MagnusNM/TANG/Hardware/Tang_v2/Datasheets/24V-12V buck/uc3843b setup.png

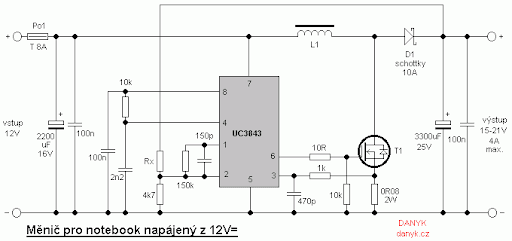
Hardware/Tang_v2/Datasheets/24V-12V buck/uc3843b setup.png
