MagnusNM/TANG/Hardware/Tang_v1-1/tang_v1-1.pdf

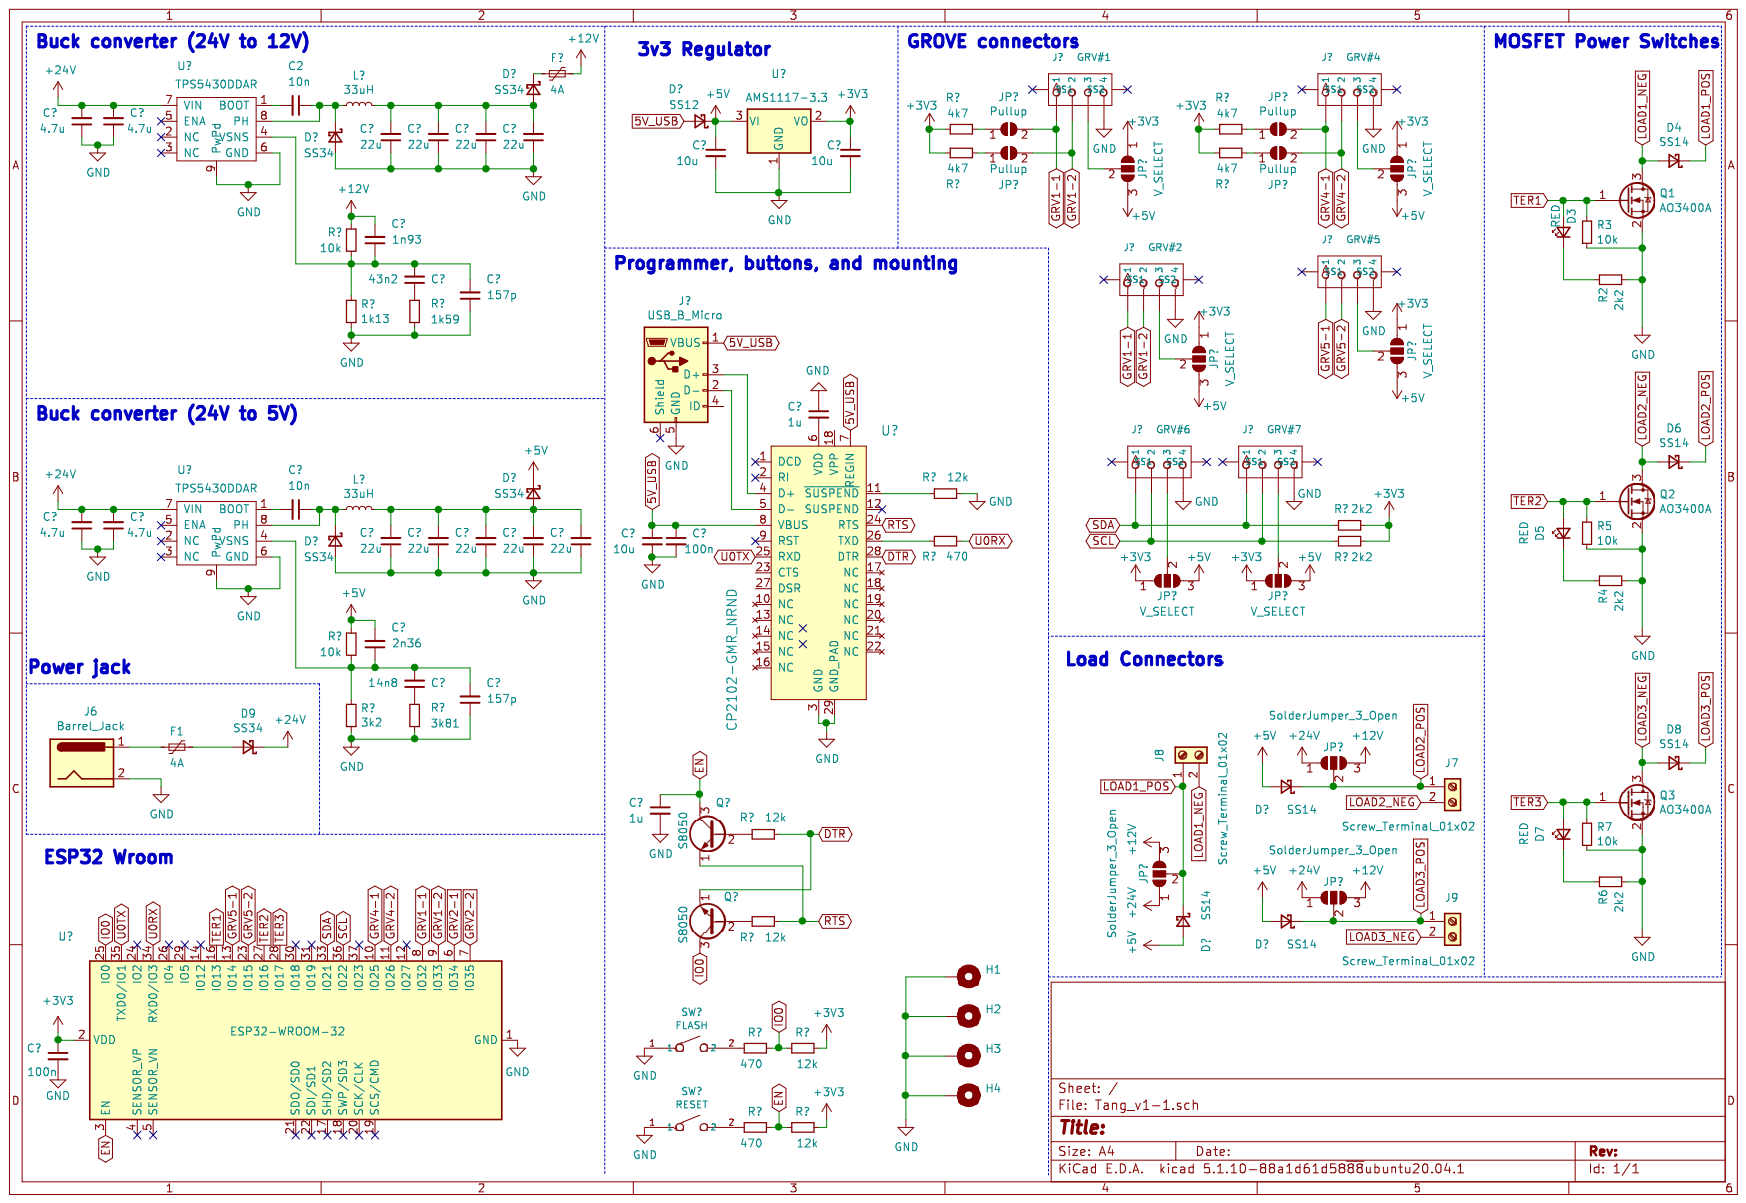
[picture p2: page 1]
