MagnusNM/TANG/Hardware/Tang_v1-0/Control_board.kicad_pcb

## KiCad design Hardware/Tang_v1-0/Control_board.kicad_pcb (2021-07-06)

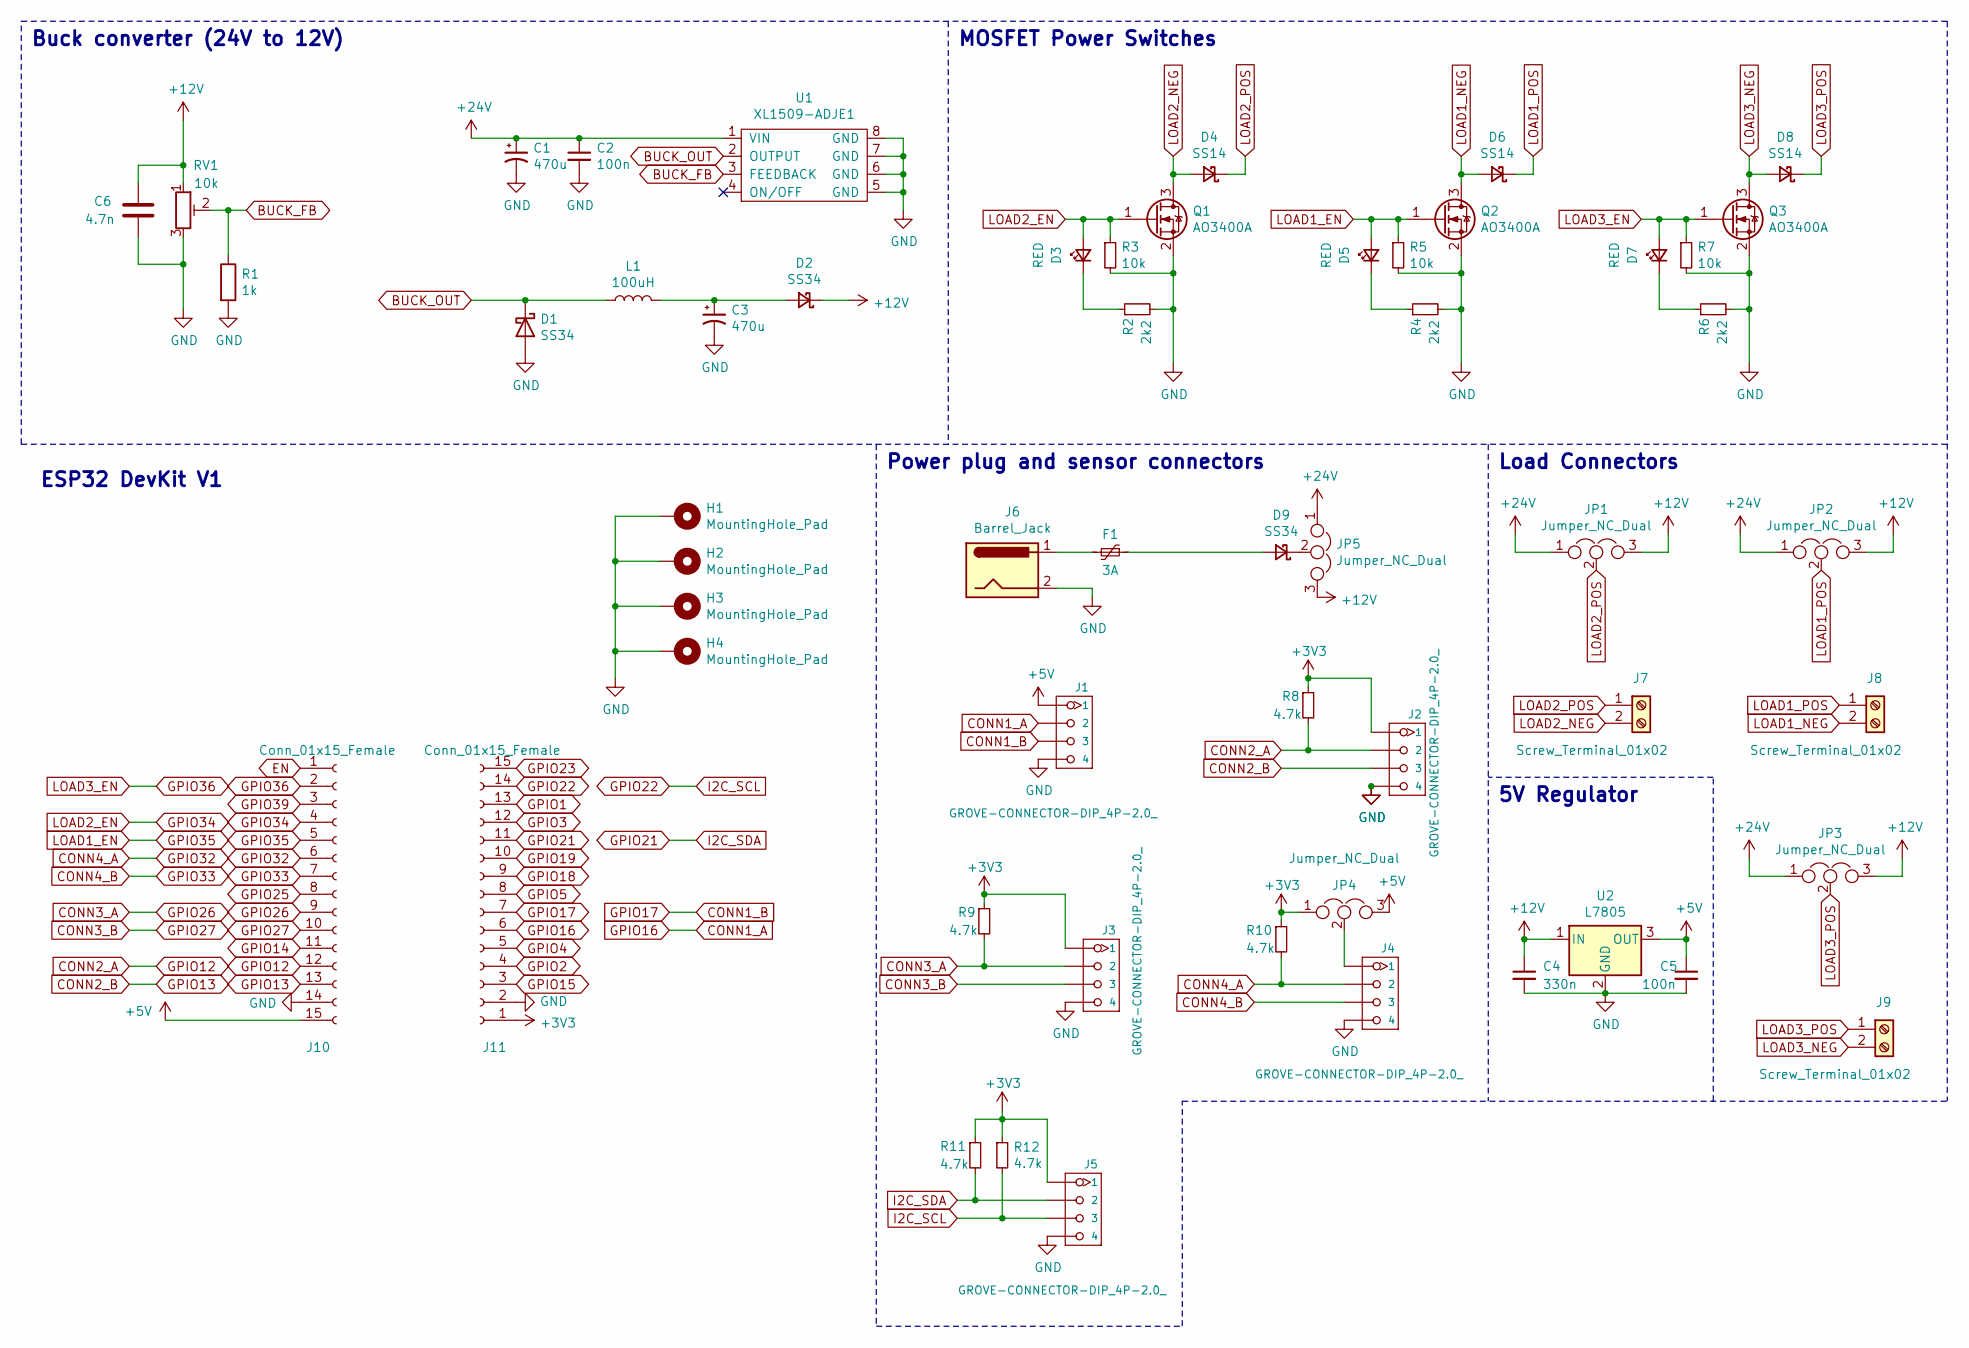
[picture p3: schematic Control_board.sch]

Parts:
C1, C3: 470u; C_Elec_10x10.2; LCSC Part # C3350
C2: 100n; C_0603_1608Metric; LCSC Part # C14663
C4: 330n; C_0805_2012Metric; LCSC Part # C1740
C5: 100n; C_0805_2012Metric; LCSC Part # C49678
C6: 4.7n; C_0402_1005Metric; LCSC Part # C1538
D1, D2, D9: SS34; D_SMA; LCSC Part # C8678
D3, D5, D7: RED; LED_0603_1608Metric; LCSC Part # C2286
D4, D6, D8: SS14; D_SMA; LCSC Part # C2480
F1: 3A; Fuse_1812_4532Metric; LCSC Part # C32404
H1, H2, H3, H4: MountingHole_Pad; MountingHole_3.2mm_M3_Pad_Via
J1, J2, J3, J4, J5: GROVE-CONNECTOR-DIP_4P-2.0_; NS-Tech_Grove_1x04_P2mm_Vertical
J6: Barrel_Jack; BarrelJack_Horizontal
J7, J8, J9: Screw_Terminal_01x02; TerminalBlock_Phoenix_MPT-0,5-2-2.54_1x02_P2.54mm_Horizontal
J10, J11: Conn_01x15_Female; PinSocket_1x15_P2.54mm_Vertical
JP1, JP2, JP3, JP4, JP5: Jumper_NC_Dual; PinHeader_1x03_P2.54mm_Vertical
L1: 100uH; Wuerth_7447211101; LCSC Part # C429814
Q1, Q2, Q3: AO3400A; SOT-23; LCSC Part # C344010
R1: 1k; R_0603_1608Metric; LCSC Part # C21190
R2, R4, R6: 2k2; R_0603_1608Metric; LCSC Part # C4190
R3, R5, R7: 10k; R_0603_1608Metric; LCSC Part # C25804
R8, R9, R10, R11, R12: 4.7k; R_0402_1005Metric; LCSC Part # C25900
RV1: 10k; Potentiometer_Bourns_3296P_Horizontal
U1: XL1509-ADJE1; SOP-8_3.9x4.9mm_P1.27mm; LCSC Part # C74192
U2: L7805; TO-263-2; LCSC Part # C15077

Connections:
+3V3: J2.1, J3.1, J5.1, J11.1, JP4.1, R8.1, R9.1, R10.1, R11.1, R12.1
+5V: C5.1, J1.1, J10.15, JP4.3, U2.3 (OUT)
+12V: C4.1, C6.1, D2.1 (K), JP1.3, JP2.3, JP3.3, JP5.3, RV1.1, U2.1 (IN)
+24V: C1.1, C2.1, JP1.1, JP2.1, JP3.1, JP5.1, U1.1 (VIN)
BUCK_FB: R1.1, RV1.2, U1.3 (FEEDBACK)
BUCK_OUT: D1.1 (K), L1.1, L1.3, U1.2 (OUTPUT)
CONN1_A: J1.2, J11.6
CONN1_B: J1.3, J11.7
CONN2_A: J2.2, J10.12, R8.2
CONN2_B: J2.3, J10.13
CONN3_A: J3.2, J10.9, R9.2
CONN3_B: J3.3, J10.10
CONN4_A: J4.2, J10.6, R10.2
CONN4_B: J4.3, J10.7
EN: J10.1
GND: C1.2, C2.2, C3.2, C4.2, C5.2, C6.2, D1.2 (A), H1.1, H2.1, H3.1, H4.1, J1.4, J2.4, J3.4, J4.4, J5.4, J6.2, J10.14, J11.2, Q1.2 (S), Q2.2 (S), Q3.2 (S), R1.2, R2.2, R3.2, R4.2, R5.2, R6.2, R7.2, RV1.3, U1.5 (GND), U1.6 (GND), U1.7 (GND), U1.8 (GND), U2.2 (GND)
GPIO1: J11.13
GPIO2: J11.4
GPIO3: J11.12
GPIO4: J11.5
GPIO5: J11.8
GPIO14: J10.11
GPIO15: J11.3
GPIO18: J11.9
GPIO19: J11.10
GPIO21: J5.2, J11.11, R11.2
GPIO22: J5.3, J11.14, R12.2
GPIO23: J11.15
GPIO25: J10.8
GPIO34: D3.2 (A), J10.4, Q1.1 (G), R3.1
GPIO35: D5.2 (A), J10.5, Q2.1 (G), R5.1
GPIO36: D7.2 (A), J10.2, Q3.1 (G), R7.1
GPIO39: J10.3
LOAD1_NEG: D6.2 (A), J8.2, Q2.3 (D)
LOAD1_POS: D6.1 (K), J8.1, JP2.2
LOAD2_NEG: D4.2 (A), J7.2, Q1.3 (D)
LOAD2_POS: D4.1 (K), J7.1, JP1.2
LOAD3_NEG: D8.2 (A), J9.2, Q3.3 (D)
LOAD3_POS: D8.1 (K), J9.1, JP3.2
unnamed: C3.1, D2.2 (A), L1.2
unnamed: D3.1 (K), R2.1
unnamed: D5.1 (K), R4.1
unnamed: D7.1 (K), R6.1
unnamed: D9.1 (K), JP5.2
unnamed: D9.2 (A), F1.1
unnamed: F1.2, J6.1
unnamed: J4.1, JP4.2

Notes on the sheet:
Buck converter (24V to 12V)
MOSFET Power Switches
Load Connectors
5V Regulator
Power plug and sensor connectors
ESP32 DevKit V1

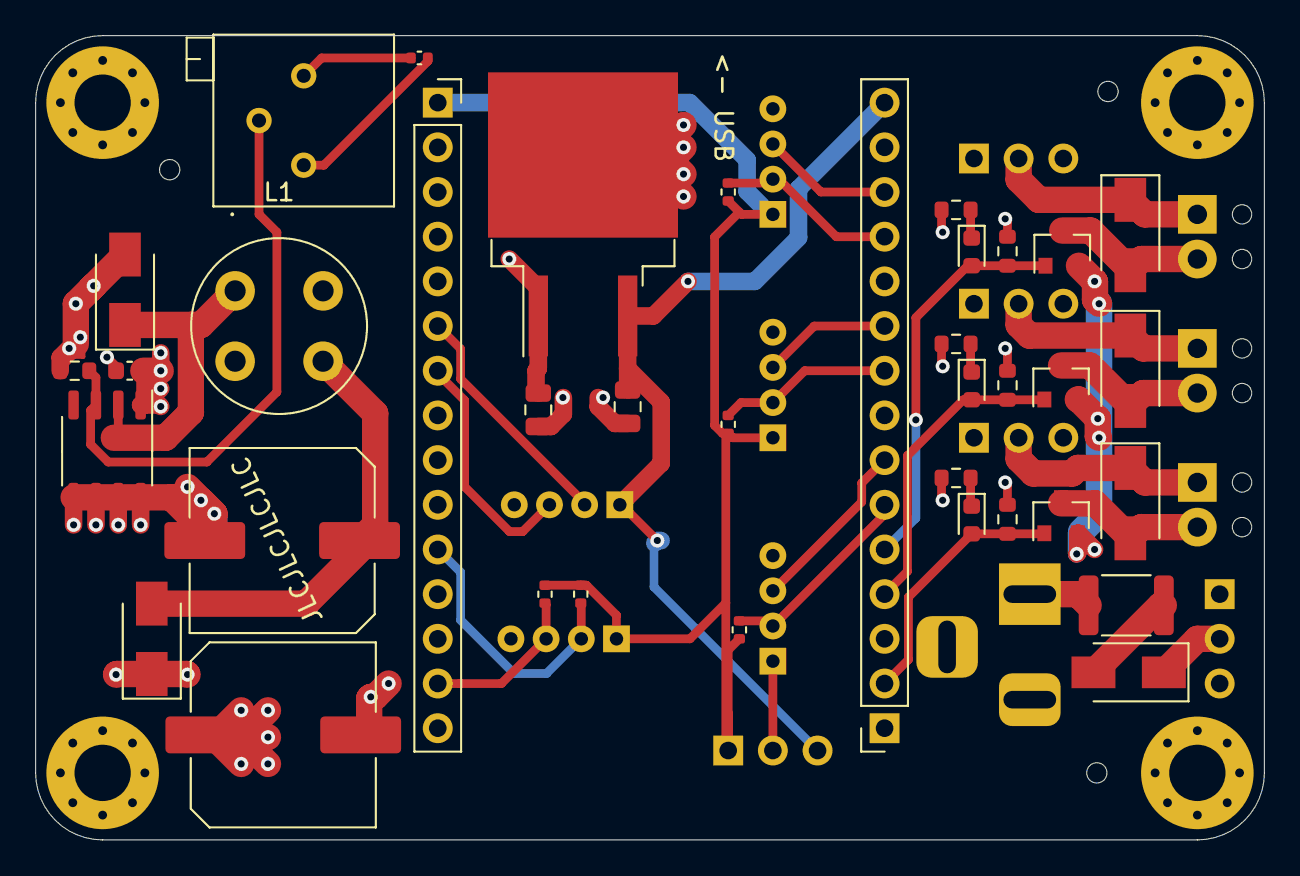
[picture p4: board Control_board.kicad_pcb from above]

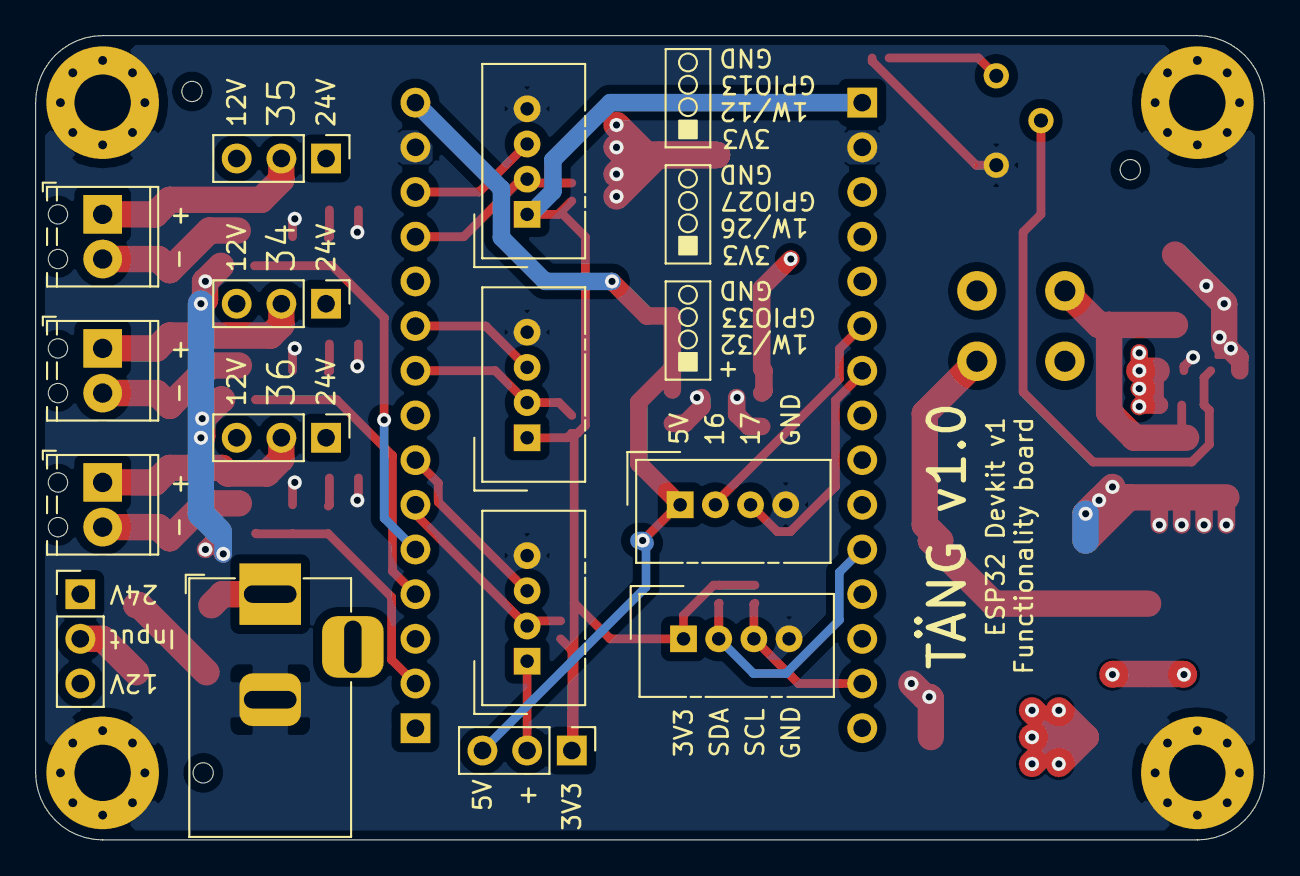
[picture p5: board Control_board.kicad_pcb from below]

Board: 4 copper layers, 69.8 x 45.7 mm, 55 parts (14 on the bottom side), 34 nets.
