MagnusNM/TANG/Hardware/Tang_v1-1/Tang_v1-1.kicad_pcb

## KiCad design Hardware/Tang_v1-1/Tang_v1-1.kicad_pcb (2021-07-13)

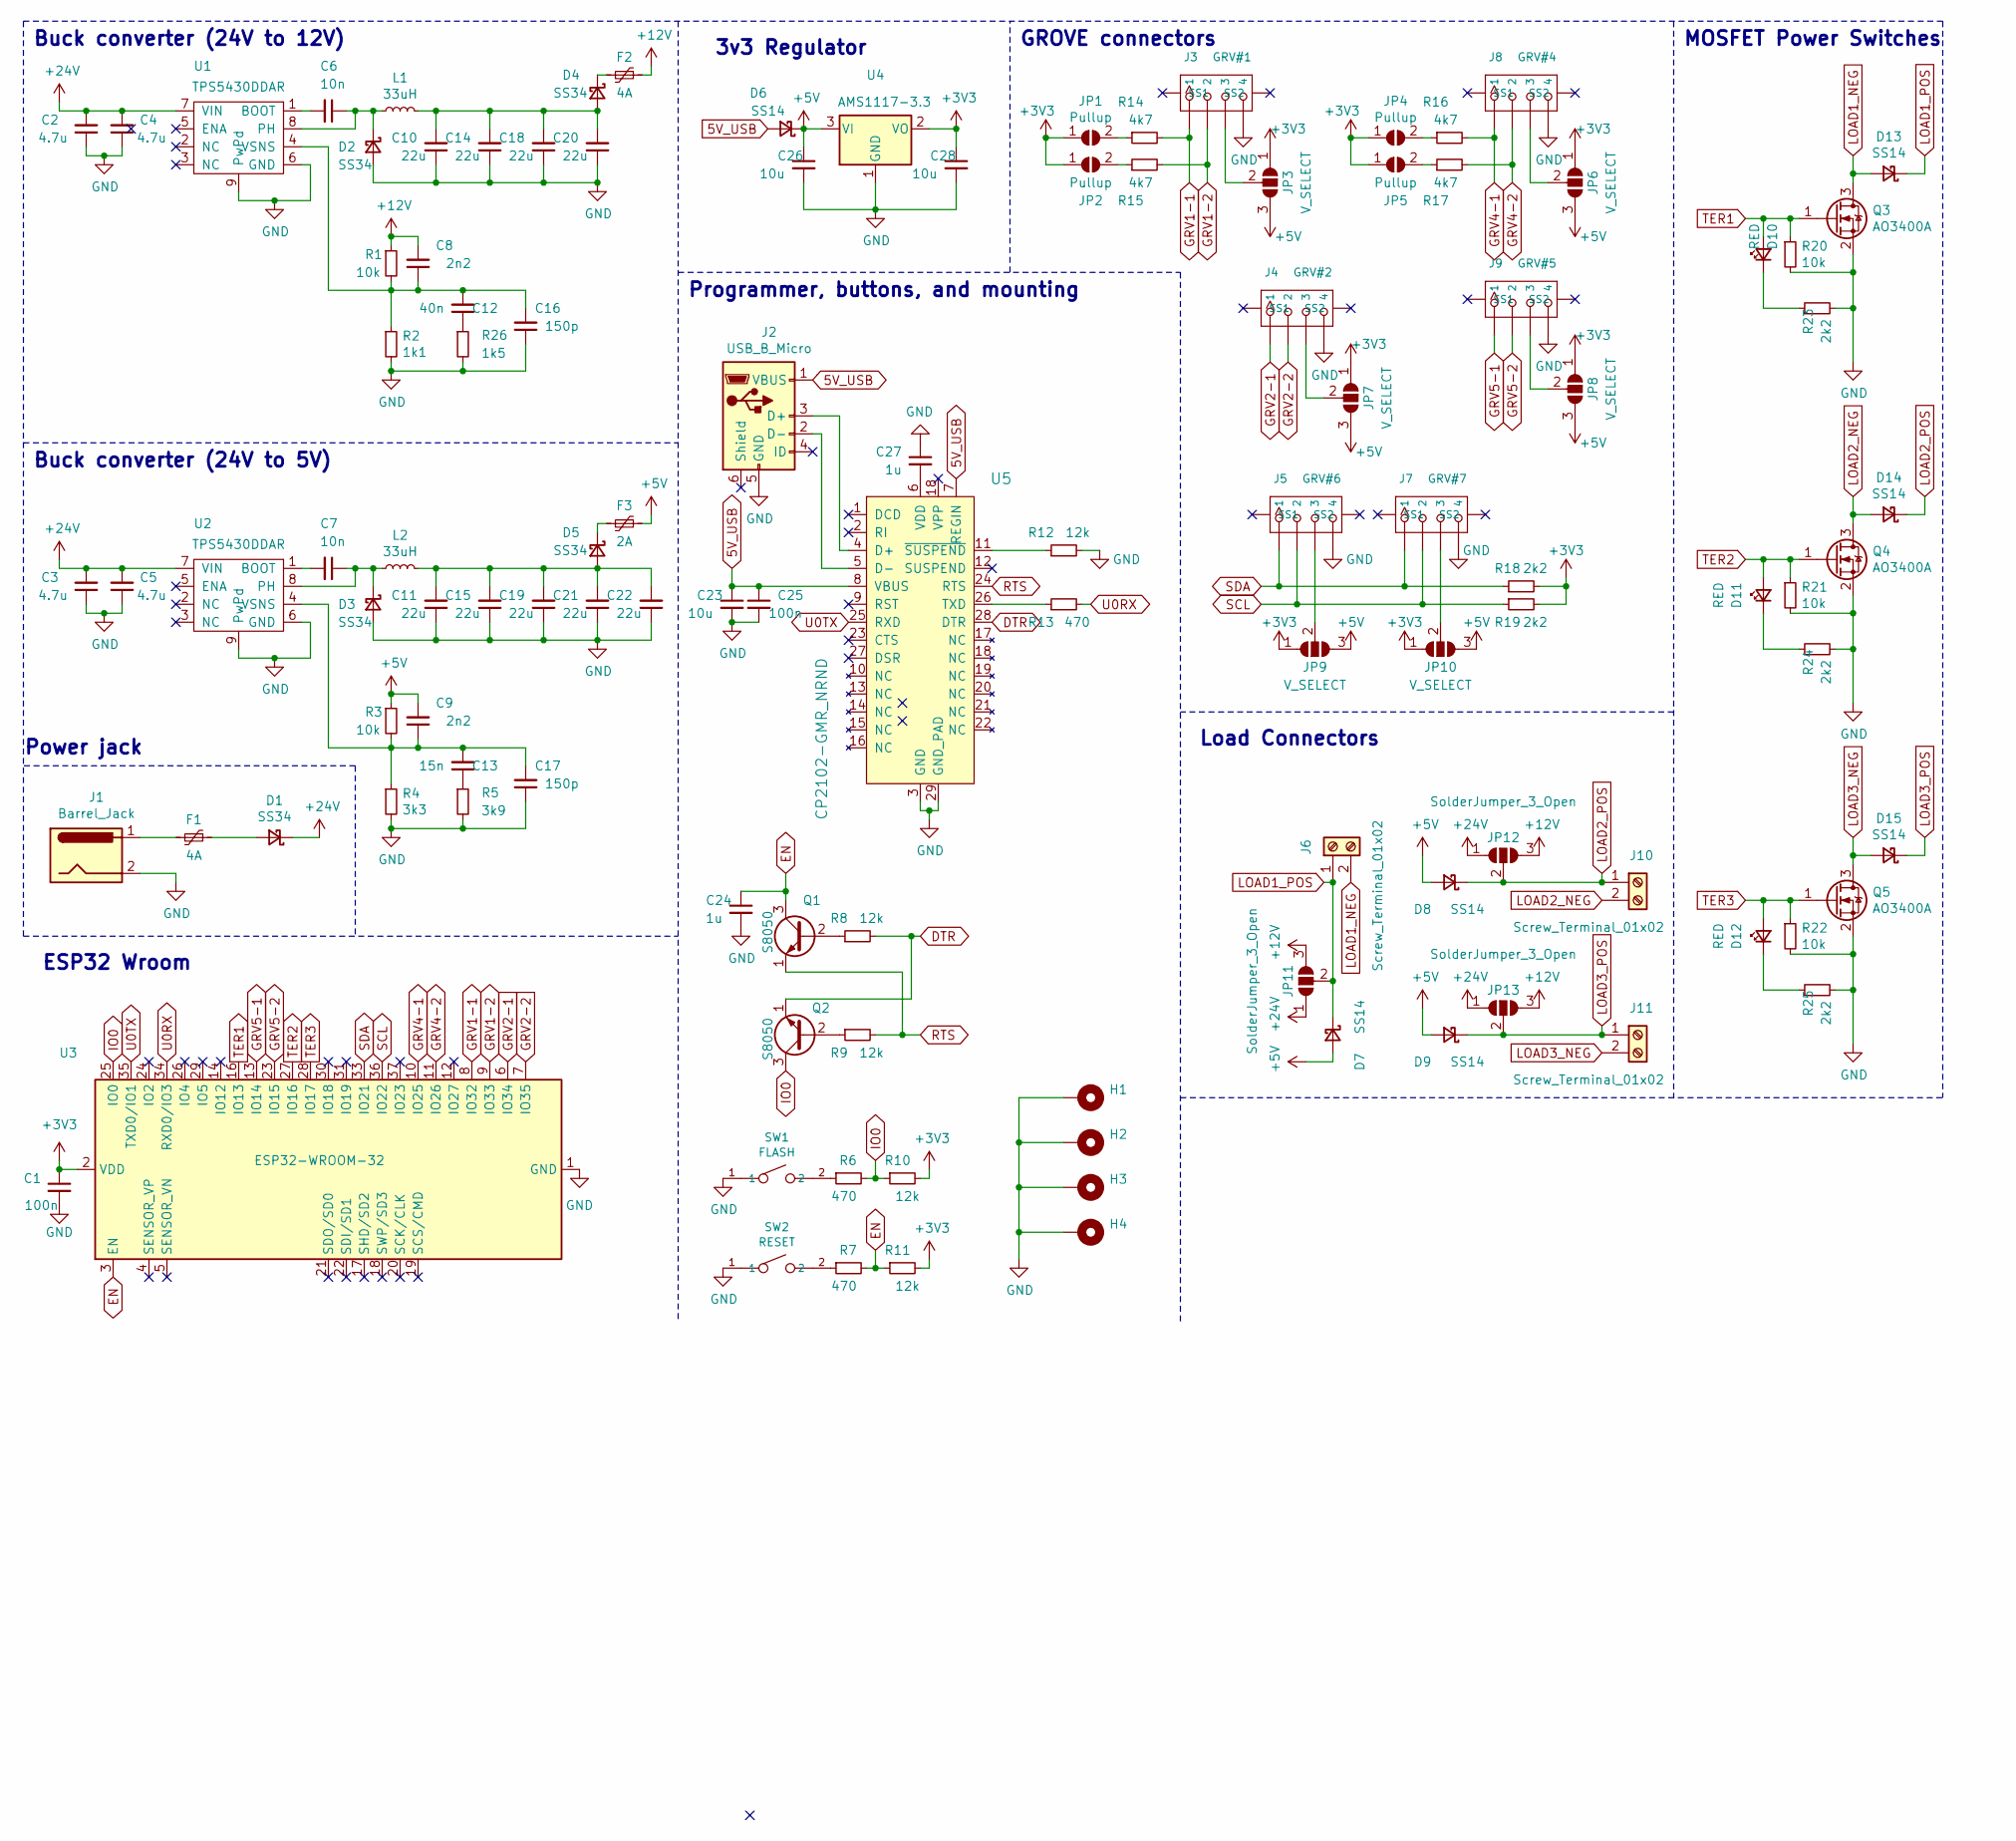
[picture p6: schematic Tang_v1-1.sch]

Parts:
C1, C25: 100n; C_0603_1608Metric; LCSC C14663
C2, C3, C4, C5: 4.7u; C_1206_3216Metric; LCSC Part # C29823
C6, C7: 10n; C_0603_1608Metric; LCSC Part # C57112
C8, C9: 2n2; C_0603_1608Metric; LCSC Part # C1604
C10, C11, C14, C15, C18, C19, C20, C21, C22: 22u; C_0805_2012Metric; LCSC Part # C45783
C12: 40n; C_0805_2012Metric; LCSC Part # C502151
C13: 15n; C_0603_1608Metric; LCSC Part # C1596
C16, C17: 150p; C_0603_1608Metric; LCSC Part # C1594
C23: 10u; C_0805_2012Metric; LCSC C15850
C24, C27: 1u; C_0603_1608Metric; LCSC C15849
C26, C28: 10u; C_0805_2012Metric; LCSC Part # C15850
D1: SS34; D_SMA; LCSC Part # C8678
D2, D3, D4, D5: SS34; D_SMA; LCSC C8678
D6, D7, D8, D9: SS14; D_SMA; LCSC C2480
D10, D11, D12: RED; LED_0603_1608Metric; LCSC Part # C2286
D13, D14, D15: SS14; D_SMA; LCSC Part # C2480
F1, F2: 4A; Fuse_1812_4532Metric; LCSC Part # C960026
F3: 2A; Fuse_1812_4532Metric; LCSC Part # C269134
H1, H2, H3, H4: MountingHole_Pad; MountingHole_3.2mm_M3_Pad_Via
J1: Barrel_Jack; BarrelJack_Horizontal
J2: USB_B_Micro; USB_Micro-B_Molex-105017-0001; LCSC C10418
J3: GRV#1; GROVE 4 pin 90deg SMD
J4: GRV#2; GROVE 4 pin 90deg SMD
J5: GRV#6; GROVE 4 pin 90deg SMD
J6, J10, J11: Screw_Terminal_01x02; TerminalBlock_Phoenix_MKDS-1,5-2-5.08_1x02_P5.08mm_Horizont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
J7: GRV#7; GROVE 4 pin 90deg SMD
J8: GRV#4; GROVE 4 pin 90deg SMD
J9: GRV#5; GROVE 4 pin 90deg SMD
JP1, JP2, JP4, JP5: Pullup; SolderJumper-2_P1.3mm_Open_RoundedPad1.0x1.5mm
JP3, JP6, JP7, JP8, JP9, JP10: V_SELECT; SolderJumper-3_P1.3mm_Open_RoundedPad1.0x1.5mm
JP11, JP12, JP13: SolderJumper_3_Open; SolderJumper-3_P1.3mm_Open_RoundedPad1.0x1.5mm
L1, L2: 33uH; L_TDG_11.5x10x4mm
Q1, Q2: S8050; SOT-23; LCSC C2146
Q3, Q4, Q5: AO3400A; SOT-23; LCSC Part # C20917
R1, R3: 10k; R_0603_1608Metric; LCSC C25804
R2: 1k1; R_0603_1608Metric; LCSC C22764
R4: 3k3; R_0603_1608Metric; LCSC C22978
R5: 3k9; R_0603_1608Metric; LCSC C23018
R6, R7, R13: 470; R_0603_1608Metric; LCSC Part # C23179
R8, R9, R10, R11, R12: 12k; R_0603_1608Metric; LCSC Part # C22790
R14, R15, R16, R17: 4k7; R_0603_1608Metric; LCSC Part # C23162
R18, R19, R23, R24, R25: 2k2; R_0603_1608Metric; LCSC Part # C4190
R20, R21, R22: 10k; R_0603_1608Metric; LCSC Part # C25804
R26: 1k5; R_0603_1608Metric; LCSC C22843
SW1: FLASH; SW_Push_SPST_NO_Alps_SKRK; MPN B3U-1000P-2P-SMD; LCSC C115357
SW2: RESET; SW_Push_SPST_NO_Alps_SKRK; MPN B3U-1000P-2P-SMD; LCSC C115357
U1, U2: TPS5430DDAR; HSOP-8-1EP_3.9x4.9mm_P1.27mm_EP2.41x3.1mm; LCSC C9864
U3: ESP32-WROOM-32; LCSC C82899
U4: AMS1117-3.3; SOT-223-3_TabPin2; LCSC C6186
U5: CP2102-GMR_NRND; VFQFN-28-1EP_5x5mm; MPN CP2102-GMR; Digi-Key_PN 336-1160-1-ND

Connections:
5V_USB: C23.1, C25.1, D6.2 (A), J2.1 (VBUS), U5.7 (REGIN), U5.8 (VBUS)
+3V3: C1.1, C28.1, JP1.1 (A), JP2.1 (A), JP3.1 (A), JP4.1 (A), JP5.1 (A), JP6.1 (A), JP7.1 (A), JP8.1 (A), JP9.1 (A), JP10.1 (A), R10.2, R11.2, R18.2, R19.2, U3.2 (VDD), U4.2 (VO)
+5V: C9.2, C26.1, D6.1 (K), D7.2 (A), D8.2 (A), D9.2 (A), F3.1, JP3.3 (B), JP6.3 (B), JP7.3 (B), JP8.3 (B), JP9.3 (B), JP10.3 (B), R3.1, U4.3 (VI)
+12V: C8.2, F2.1, JP11.3 (B), JP12.3 (B), JP13.3 (B), R1.1
+24V: C2.2, C3.2, C4.2, C5.2, D1.1 (K), JP11.1 (A), JP12.1 (A), JP13.1 (A), U1.7 (VIN), U2.7 (VIN)
DTR: Q2.1 (E), R8.2, U5.28 (DTR)
EN: C24.1, Q1.3 (C), R7.2, R11.1, U3.3 (EN)
GND: C1.2, C2.1, C3.1, C4.1, C5.1, C10.1, C11.1, C14.1, C15.1, C16.1, C17.1, C18.1, C19.1, C20.1, C21.1, C22.1, C23.2, C24.2, C25.2, C26.2, C27.1, C28.2, D2.2 (A), D3.2 (A), H1.1, H2.1, H3.1, H4.1, J1.2, J2.5 (GND), J3.4, J4.4, J5.4, J7.4, J8.4, J9.4, Q3.2 (S), Q4.2 (S), Q5.2 (S), R2.2, R4.2, R5.2, R12.2, R20.2, R21.2, R22.2, R23.2, R24.2, R25.2, R26.2, SW1.1, SW2.1, U1.6 (GND), U1.9 (PwPd), U2.6 (GND), U2.9 (PwPd), U3.1 (GND), U3.15 (GND), U3.38 (GND), U3.39 (GND), U4.1 (GND), U5.3 (GND), U5.29 (GND_PAD)
GRV1-1: J3.1, R14.2, U3.8 (IO32)
GRV1-2: J3.2, R15.2, U3.9 (IO33)
GRV2-1: J4.1, U3.6 (IO34)
GRV2-2: J4.2, U3.7 (IO35)
GRV4-1: J8.1, R16.2, U3.10 (IO25)
GRV4-2: J8.2, R17.2, U3.11 (IO26)
GRV5-1: J9.1, U3.13 (IO14)
GRV5-2: J9.2, U3.23 (IO15)
IO0: Q2.3 (C), R6.2, R10.1, U3.25 (IO0)
LOAD1_NEG: D13.2 (A), J6.2, Q3.3 (D)
LOAD1_POS: D7.1 (K), D13.1 (K), J6.1, JP11.2 (C)
LOAD2_NEG: D14.2 (A), J10.2, Q4.3 (D)
LOAD2_POS: D8.1 (K), D14.1 (K), J10.1, JP12.2 (C)
LOAD3_NEG: D15.2 (A), J11.2, Q5.3 (D)
LOAD3_POS: D9.1 (K), D15.1 (K), J11.1, JP13.2 (C)
unnamed: C6.1, D2.1 (K), L1.1, U1.8 (PH)
unnamed: C6.2, U1.1 (BOOT)
unnamed: C7.1, D3.1 (K), L2.1, U2.8 (PH)
unnamed: C7.2, U2.1 (BOOT)
unnamed: C10.2, C14.2, C18.2, C20.2, D4.2 (A), L1.2
unnamed: C11.2, C15.2, C19.2, C21.2, C22.2, D5.2 (A), L2.2
unnamed: C12.1, R26.1
unnamed: C8.1, C12.2, C16.2, R1.2, R2.1, U1.4 (VSNS)
unnamed: C13.1, R5.1
unnamed: C9.1, C13.2, C17.2, R3.2, R4.1, U2.4 (VSNS)
unnamed: C27.2, U5.6 (VDD)
unnamed: D1.2 (A), F1.1
unnamed: D4.1 (K), F2.2
unnamed: D5.1 (K), F3.2
unnamed: D10.1 (K), R23.1
unnamed: D11.1 (K), R24.1
unnamed: D12.1 (K), R25.1
unnamed: F1.2, J1.1
unnamed: J2.2 (D-), U5.5 (D-)
unnamed: J2.3 (D+), U5.4 (D+)
unnamed: J3.3, JP3.2 (C)
unnamed: J4.3, JP7.2 (C)
unnamed: J5.3, JP9.2 (C)
unnamed: J7.3, JP10.2 (C)
unnamed: J8.3, JP6.2 (C)
unnamed: J9.3, JP8.2 (C)
unnamed: JP1.2 (B), R14.1
unnamed: JP2.2 (B), R15.1
unnamed: JP4.2 (B), R16.1
unnamed: JP5.2 (B), R17.1
unnamed: Q1.2 (B), R8.1
unnamed: Q2.2 (B), R9.1
unnamed: R6.1, SW1.2
unnamed: R7.1, SW2.2
unnamed: R12.1, U5.11 (~SUSPEND)
unnamed: R13.1, U5.26 (TXD)
RTS: Q1.1 (E), R9.2, U5.24 (RTS)
SCL: J5.2, J7.2, R19.1, U3.36 (IO22)
SDA: J5.1, J7.1, R18.1, U3.33 (IO21)
TER1: D10.2 (A), Q3.1 (G), R20.1, U3.16 (IO13)
TER2: D11.2 (A), Q4.1 (G), R21.1, U3.27 (IO16)
TER3: D12.2 (A), Q5.1 (G), R22.1, U3.28 (IO17)
U0RX: R13.2, U3.34 (RXD0/IO3)
U0TX: U3.35 (TXD0/IO1), U5.25 (RXD)

Notes on the sheet:
Buck converter (24V to 12V)
MOSFET Power Switches
Load Connectors
Programmer, buttons, and mounting
ESP32 Wroom
3v3 Regulator
Buck converter (24V to 5V)
GROVE connectors
Power jack

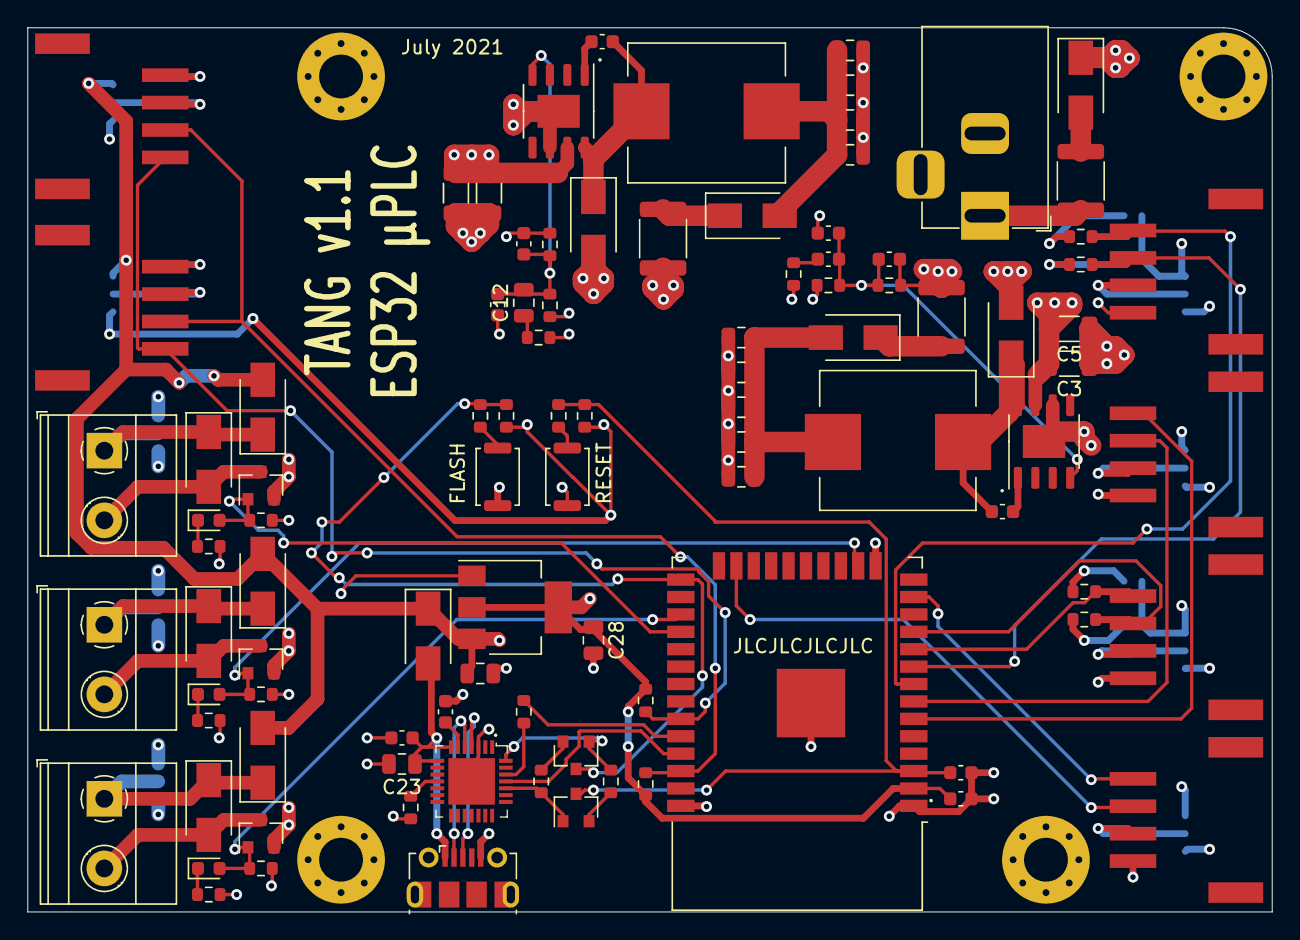
[picture p7: board Tang_v1-1.kicad_pcb from above]

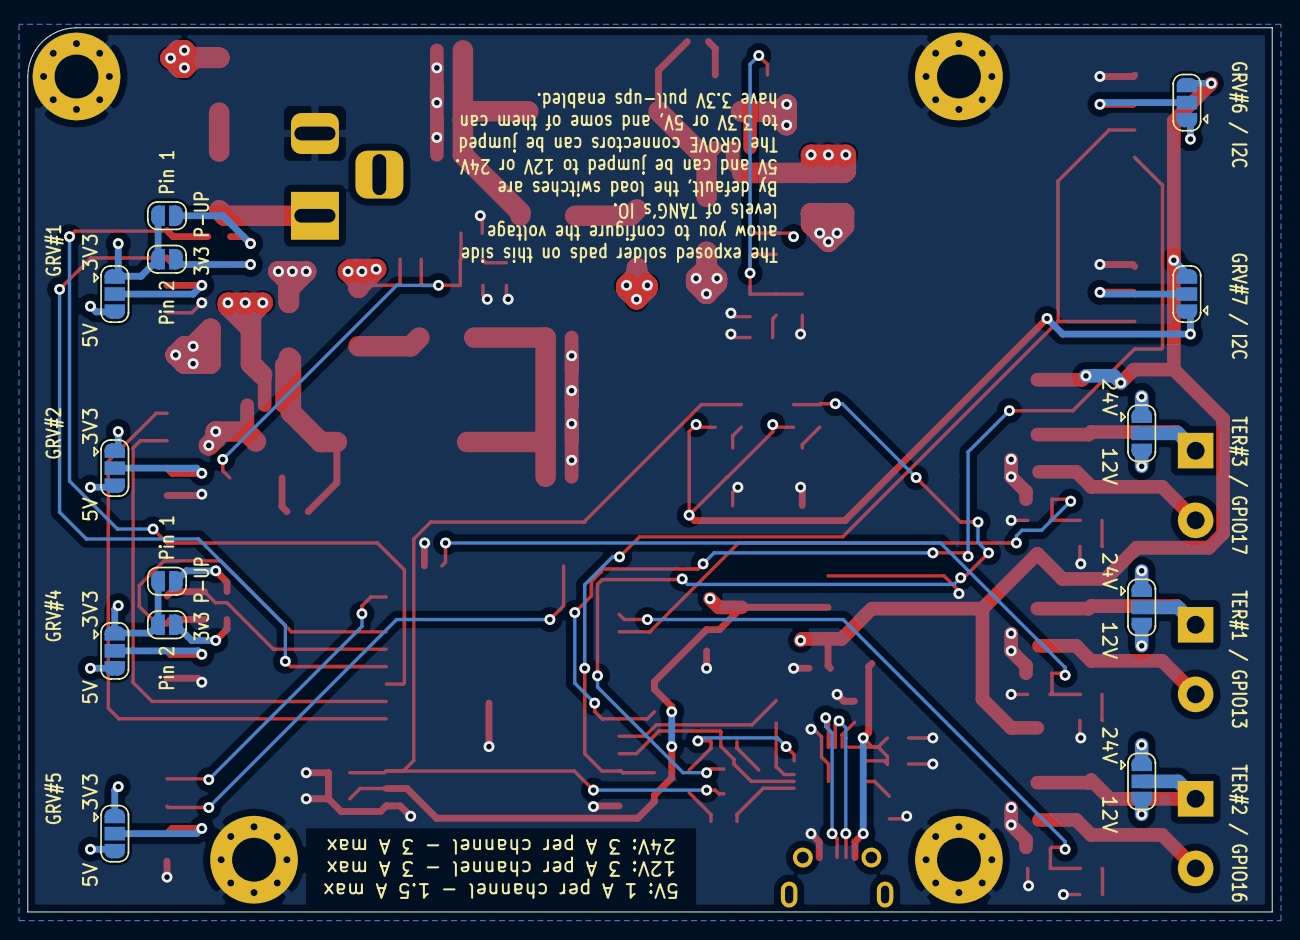
[picture p8: board Tang_v1-1.kicad_pcb from below]

Board: 4 copper layers, 90.8 x 64.5 mm, 114 parts (13 on the bottom side), 67 nets.
