MagnusNM/TANG/Firmware/MQTT_Mining_Controller_ESP32/include/network_info-EDITME.h

/*******************************************
Put your own info here and rename this file
to "network_info.h" otherwise the code won't 
compile. 
*******************************************/

const char* ssid = "your_ssid";
const char* password =  "your_wifi_pwd";
const char* mqtt_server = "your_mqtt_server_ip";
