MagnusNM/TANG/(commit log)

2021-07-06 Create Put pcb files here pls.txt
2021-07-06 Adding TANG v1 to repo
    [Control_board-B_Cu.gbr, Control_board-B_Mask.gbr, Control_board-B_Paste.gbr, Control_board-B_SilkS.gbr, Control_board-Edge_Cuts.gbr, Control_board-F_Cu.gbr, Control_board-F_Mask.gbr, Control_board-F_Paste.gbr]
2021-07-07 Started on Tang v2
    [Tang_v2.sch]
2021-07-08 Added power switches
    [Tang_v2.sch]
2021-07-13 Added v1.1 and v2 WIP
    [Control_board-B_Cu.gbr, Control_board-B_Mask.gbr, Control_board-B_Paste.gbr, Control_board-B_SilkS.gbr, Control_board-Edge_Cuts.gbr, Control_board-F_Cu.gbr, Control_board-F_Mask.gbr, Control_board-F_Paste.gbr]
